alexiszbik/midi2cvr4/(commit log)

2026-07-06 Add missing gate output + fix addr for mcp4725
    [midi2cvr4.ino]
2026-07-10 readme & schematic
